donfbecker/BUM-Logger/pcb/mkr-sensor-shield-with-modem/mkr-sensor-shield-with-modem.kicad_pcb

## KiCad design pcb/mkr-sensor-shield-with-modem/mkr-sensor-shield-with-modem.kicad_pcb (2025-12-06)

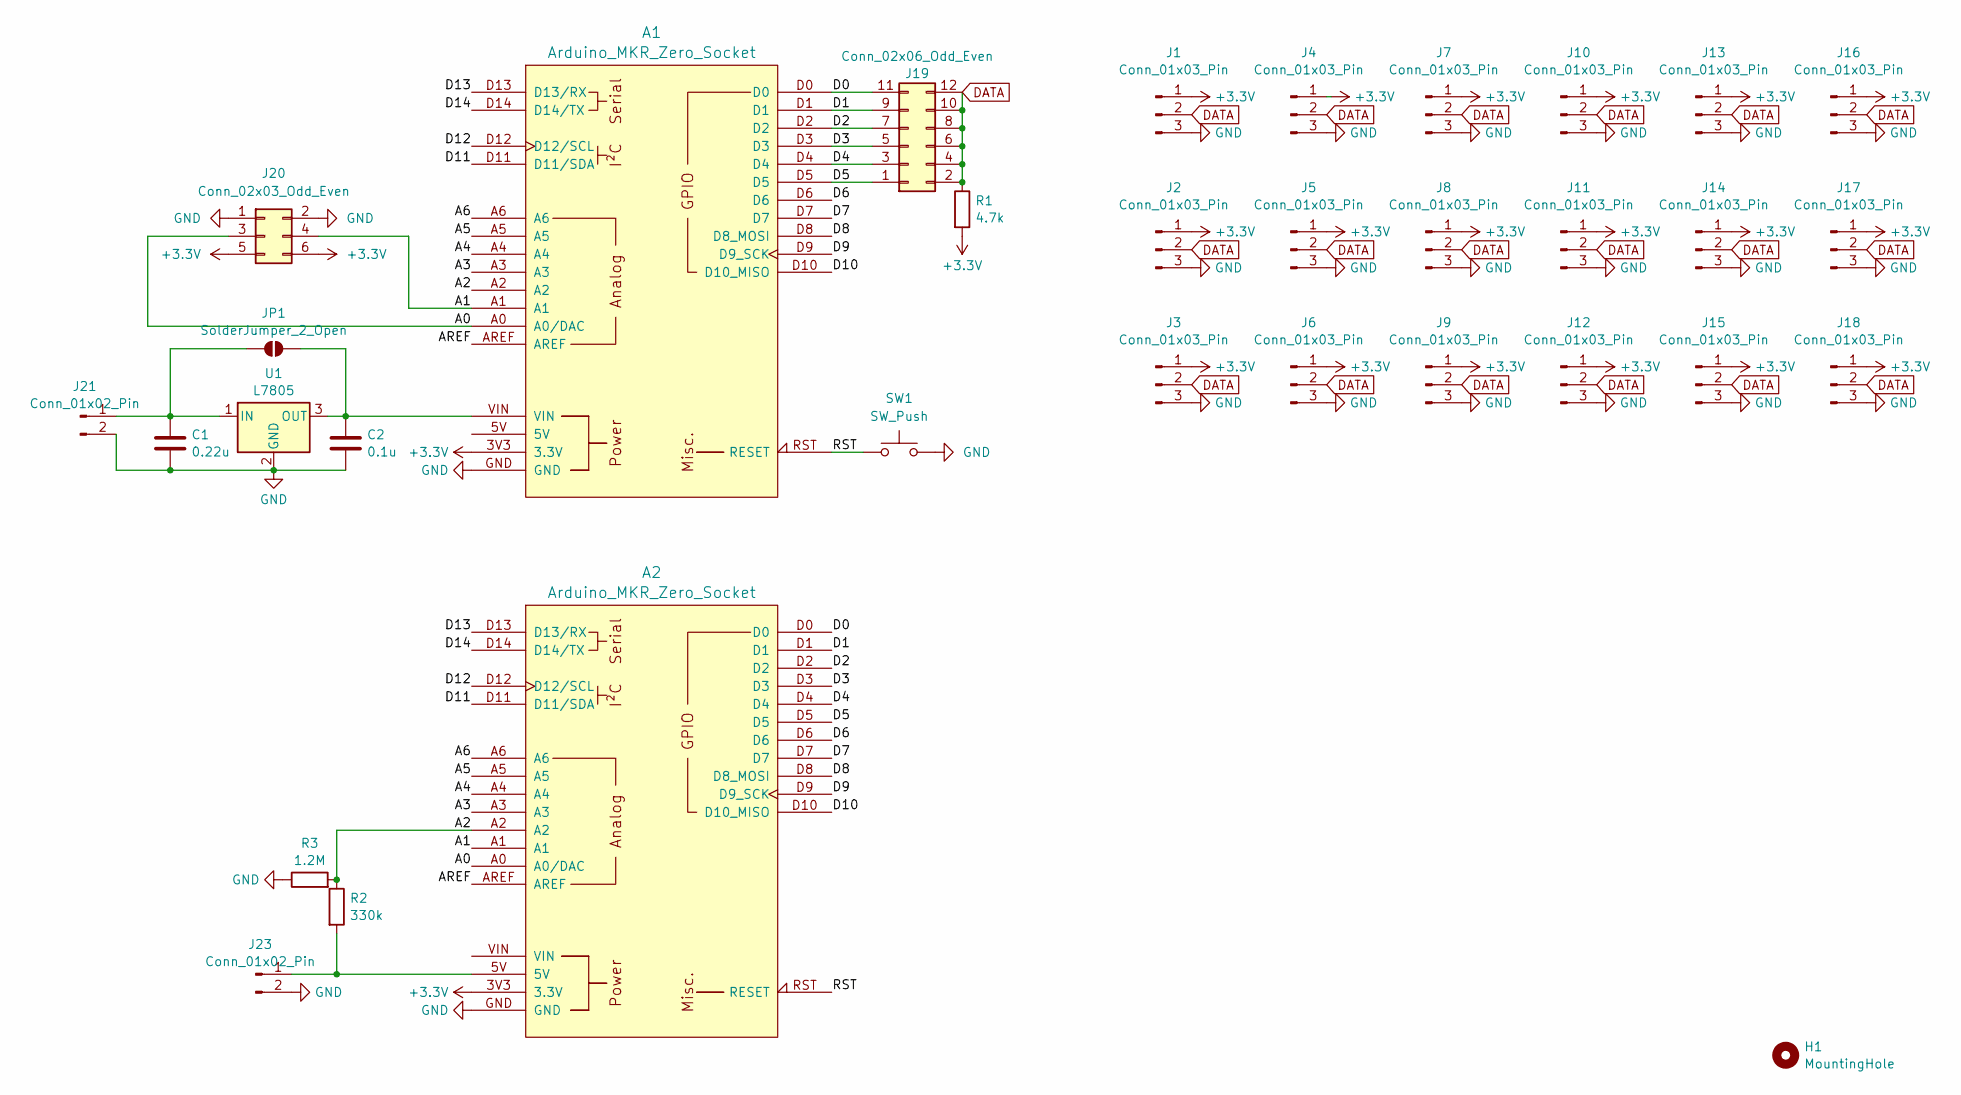
[picture p1: schematic mkr-sensor-shield-with-modem.kicad_sch]

Parts:
A1, A2: Arduino_MKR_Zero_Socket
C1: 0.22u; C_1206_3216Metric
C2: 0.1u; C_1206_3216Metric
H1: MountingHole; MountingHole_4.3mm_M4
J1, J2, J3, J4, J5, J6, J7, J8, J9, J10, J11, J12, J13, J14, J15, J16, J17, J18: Conn_01x03_Pin; JST_XH_B3B-XH-A_1x03_P2.50mm_Vertical
J19: Conn_02x06_Odd_Even; PinHeader_2x06_P2.54mm_Vertical
J20: Conn_02x03_Odd_Even; PinHeader_2x03_P2.54mm_Vertical
J21, J23: Conn_01x02_Pin; Power_Solder_Pads
JP1: SolderJumper_2_Open; SolderJumper-2_P1.3mm_Open_TrianglePad1.0x1.5mm
R1: 4.7k; R_Axial_DIN0207_L6.3mm_D2.5mm_P10.16mm_Horizontal
R2: 330k; R_Axial_DIN0207_L6.3mm_D2.5mm_P10.16mm_Horizontal
R3: 1.2M; R_Axial_DIN0207_L6.3mm_D2.5mm_P10.16mm_Horizontal
SW1: SW_Push; SW_PUSH_6mm
U1: L7805; SOT-223

Connections:
+3.3V: A1.3V3 (3.3V), A2.3V3 (3.3V), J1.1, J2.1, J3.1, J4.1, J5.1, J6.1, J7.1, J8.1, J9.1, J10.1, J11.1, J12.1, J13.1, J14.1, J15.1, J16.1, J17.1, J18.1, J20.5, J20.6, R1.2
/A0: A1.A0 (A0/DAC), A2.A0 (A0/DAC), J20.3
/A1: A1.A1, A2.A1, J20.4
/A2: A1.A2, A2.A2, R2.1, R3.2
/A3: A1.A3, A2.A3
/A4: A1.A4, A2.A4
/A5: A1.A5, A2.A5
/A6: A1.A6, A2.A6
/AREF: A1.AREF, A2.AREF
/D0: A1.D0, A2.D0, J19.11
/D1: A1.D1, A2.D1, J19.9
/D2: A1.D2, A2.D2, J19.7
/D3: A1.D3, A2.D3, J19.5
/D4: A1.D4, A2.D4, J19.3
/D5: A1.D5, A2.D5, J19.1
/D6: A1.D6, A2.D6
/D7: A1.D7, A2.D7
/D8: A1.D8 (D8_MOSI), A2.D8 (D8_MOSI)
/D9: A1.D9 (D9_SCK), A2.D9 (D9_SCK)
/D10: A1.D10 (D10_MISO), A2.D10 (D10_MISO)
/D11: A1.D11 (D11/SDA), A2.D11 (D11/SDA)
/D12: A1.D12 (D12/SCL), A2.D12 (D12/SCL)
/D13: A1.D13 (D13/RX), A2.D13 (D13/RX)
/D14: A1.D14 (D14/TX), A2.D14 (D14/TX)
/RST: A1.RST (RESET), A2.RST (RESET), SW1.1
DATA: J1.2, J2.2, J3.2, J4.2, J5.2, J6.2, J7.2, J8.2, J9.2, J10.2, J11.2, J12.2, J13.2, J14.2, J15.2, J16.2, J17.2, J18.2, J19.2, J19.4, J19.6, J19.8, J19.10, J19.12, R1.1
GND: A1.GND, A2.GND, C1.2, C2.2, J1.3, J2.3, J3.3, J4.3, J5.3, J6.3, J7.3, J8.3, J9.3, J10.3, J11.3, J12.3, J13.3, J14.3, J15.3, J16.3, J17.3, J18.3, J20.1, J20.2, J21.2, J23.2, R3.1, SW1.2, U1.2 (GND)
unnamed: C1.1, J21.1, JP1.1 (A), U1.1 (IN)
unnamed: A2.5V, J23.1, R2.2
unnamed: A1.VIN, C2.1, JP1.2 (B), U1.3 (OUT)

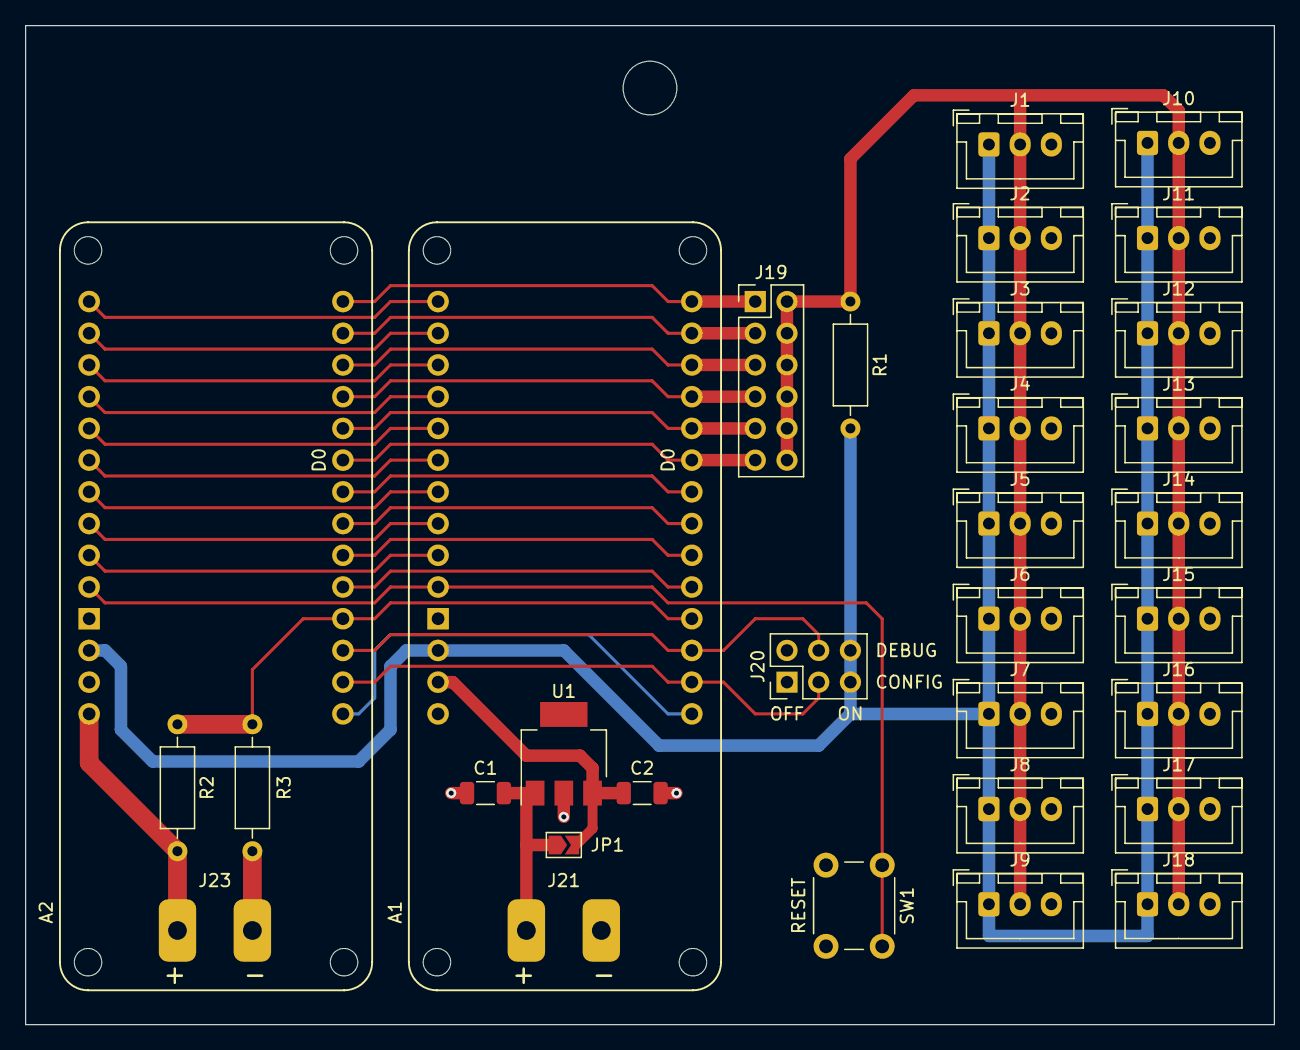
[picture p2: board mkr-sensor-shield-with-modem.kicad_pcb from above]

Board: 2 copper layers, 100.0 x 80.0 mm, 33 parts (0 on the bottom side), 30 nets.
