donfbecker/BUM-Logger/pcb/mkr-sensor-shield/mkr-sensor-shield.kicad_pcb

## KiCad design pcb/mkr-sensor-shield/mkr-sensor-shield.kicad_pcb (2024-03-21)

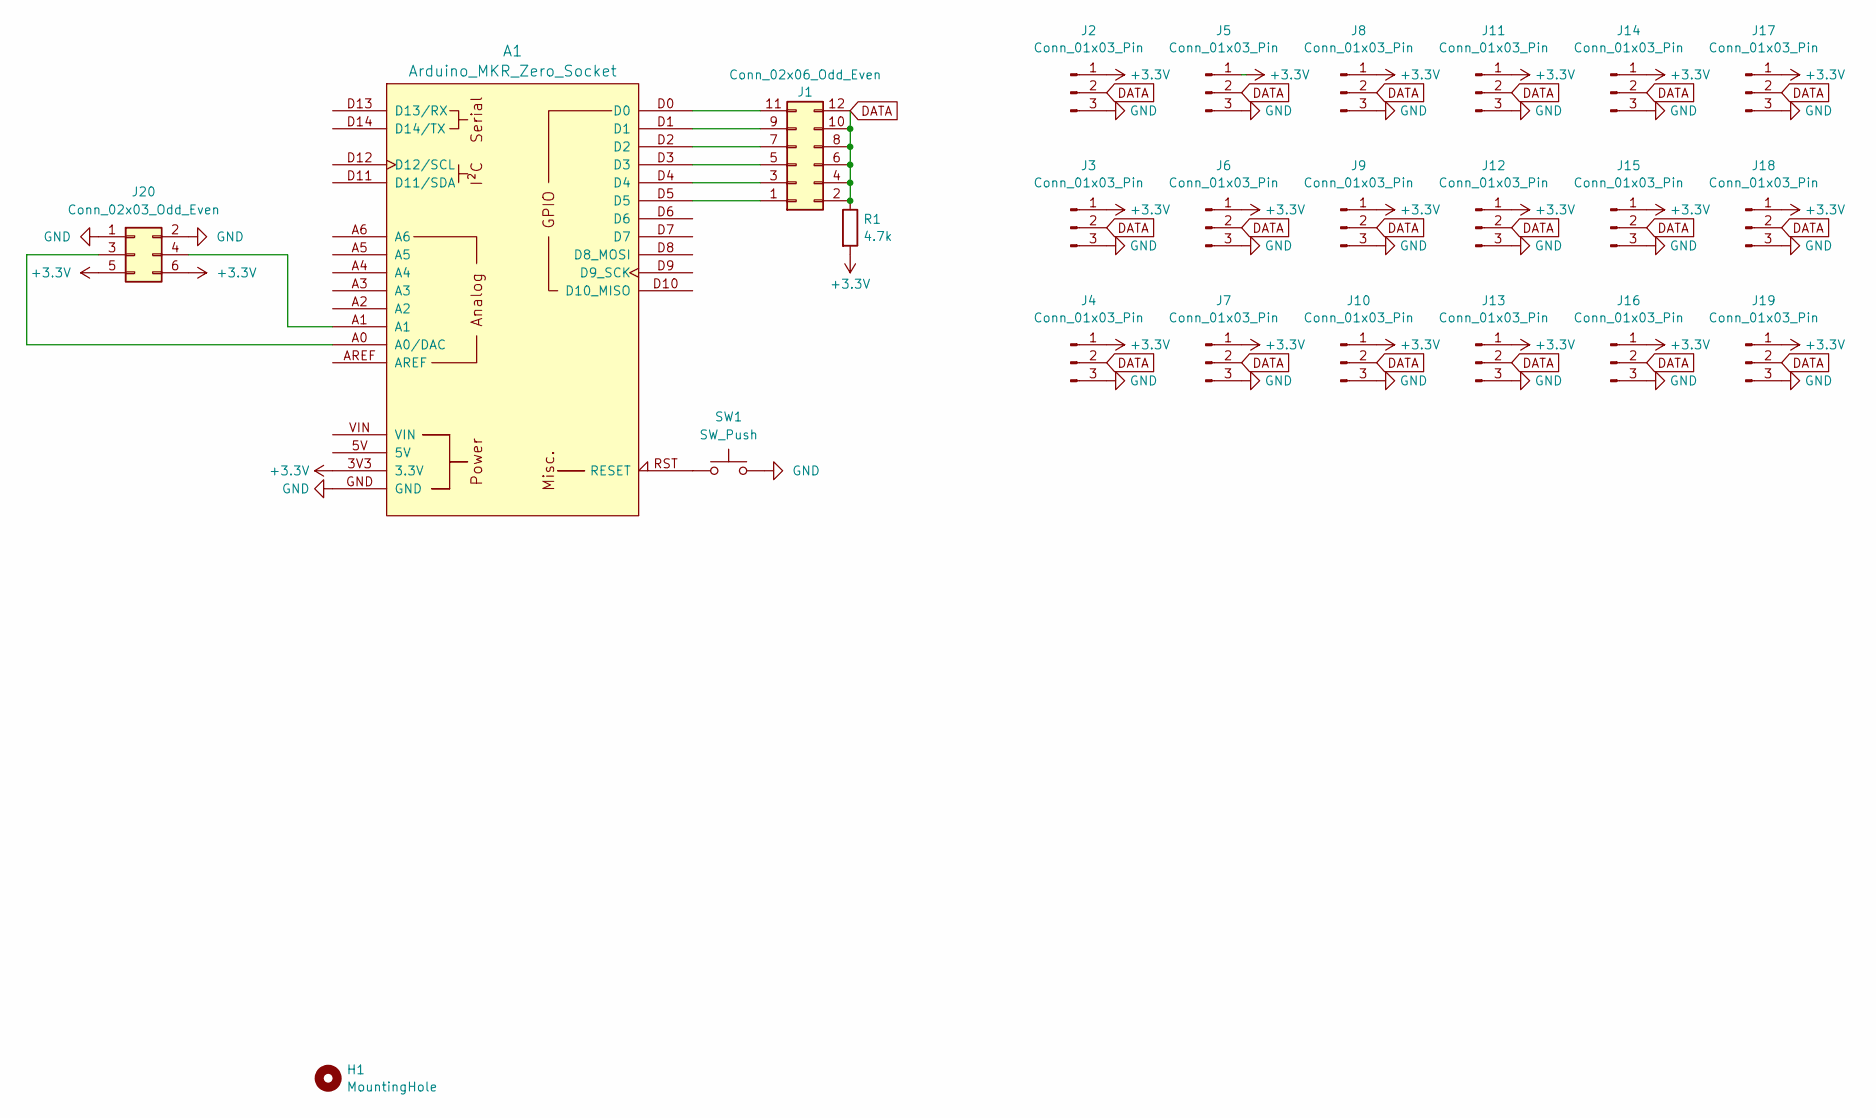
[picture p3: schematic mkr-sensor-shield.kicad_sch]

Parts:
A1: Arduino_MKR_Zero_Socket
H1: MountingHole; MountingHole_4.3mm_M4
J1: Conn_02x06_Odd_Even; PinHeader_2x06_P2.54mm_Vertical
J2, J3, J4, J5, J6, J7, J8, J9, J10, J11, J12, J13, J14, J15, J16, J17, J18, J19: Conn_01x03_Pin; JST_XH_B3B-XH-A_1x03_P2.50mm_Vertical
J20: Conn_02x03_Odd_Even; PinHeader_2x03_P2.54mm_Vertical
R1: 4.7k; R_Axial_DIN0207_L6.3mm_D2.5mm_P10.16mm_Horizontal
SW1: SW_Push; SW_PUSH_6mm

Connections:
+3.3V: A1.3V3 (3.3V), J2.1, J3.1, J4.1, J5.1, J6.1, J7.1, J8.1, J9.1, J10.1, J11.1, J12.1, J13.1, J14.1, J15.1, J16.1, J17.1, J18.1, J19.1, J20.5, J20.6, R1.2
DATA: J1.2, J1.4, J1.6, J1.8, J1.10, J1.12, J2.2, J3.2, J4.2, J5.2, J6.2, J7.2, J8.2, J9.2, J10.2, J11.2, J12.2, J13.2, J14.2, J15.2, J16.2, J17.2, J18.2, J19.2, R1.1
GND: A1.GND, J2.3, J3.3, J4.3, J5.3, J6.3, J7.3, J8.3, J9.3, J10.3, J11.3, J12.3, J13.3, J14.3, J15.3, J16.3, J17.3, J18.3, J19.3, J20.1, J20.2, SW1.2
unnamed: A1.A0 (A0/DAC), J20.3
unnamed: A1.RST (RESET), SW1.1
unnamed: A1.D5, J1.1
unnamed: A1.D4, J1.3
unnamed: A1.D3, J1.5
unnamed: A1.D2, J1.7
unnamed: A1.D1, J1.9
unnamed: A1.D0, J1.11
unnamed: A1.A1, J20.4

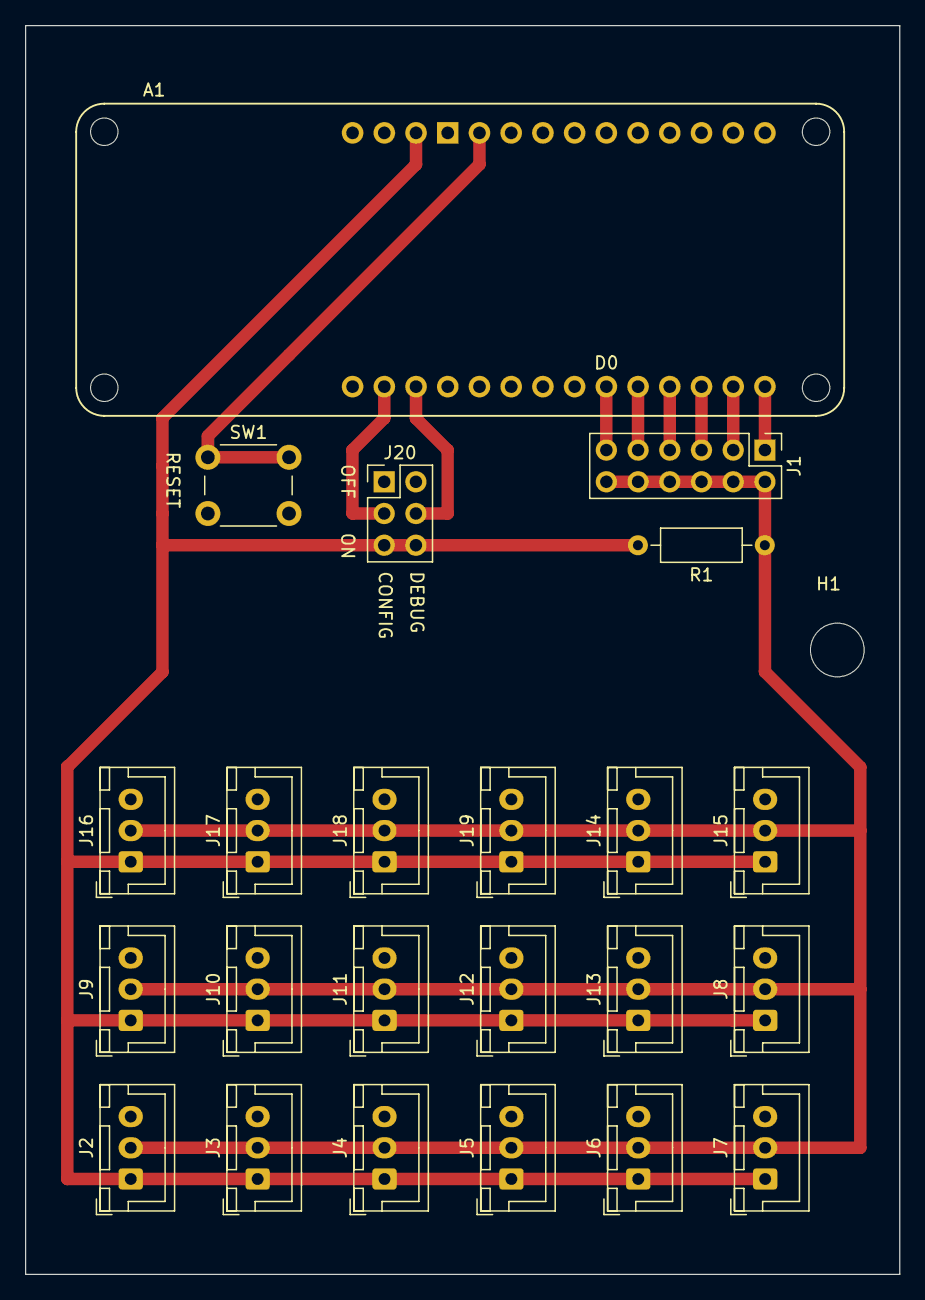
[picture p4: board mkr-sensor-shield.kicad_pcb from above]

Board: 2 copper layers, 70.0 x 100.0 mm, 24 parts (0 on the bottom side), 12 nets.
