donfbecker/BUM-Logger/(commit log)

2024-02-15 Fix capitalization to match repo on GitHub
    [BUM-Logger.ino]
2024-03-21 Add support for monitoring second battery, and logging the value. Fix modem not working after deep sleep. Fix sensorCount value when removing sensors
    [BUM-Logger.ino, client.ino, configuration.ino, logger.ino]
2024-03-21 Add KiCad PCB files
    [mkr-sensor-shield-B_Adhesive.gbr, mkr-sensor-shield-B_Courtyard.gbr, mkr-sensor-shield-B_Cu.gbr, mkr-sensor-shield-B_Fab.gbr, mkr-sensor-shield-B_Mask.gbr, mkr-sensor-shield-B_Paste.gbr, mkr-sensor-shield-B_Silkscreen.gbr, mkr-sensor-shield-Edge_Cuts.gbr]
2024-03-31 Add GSM Timeout configuration value. Add Lux sensor
2025-12-06 Remove backups from repo. Add jumper to bypass voltage regulator
    [mkr-sensor-shield-with-modem.kicad_pcb, mkr-sensor-shield-with-modem.kicad_sch]
